Hubitus/Psi_Unit_Firmware/docs/ru/USER_GUIDE.md

> **Языки:** [English](../../USER_GUIDE.md) | Русский

> Руководство пользователя прибора **Psi_Unit** (прошивка **v0.1.0**).  
> Сборка и прошивка — [README.md](README.md), [HARDWARE.md](../../HARDWARE.md), [BOM.md](BOM.md).

# Инструкция по эксплуатации
Документ для **эксплуатации готового прибора**: меню OLED, Wi‑Fi, безопасность, ошибки.  
Не описывает пайку, загрузку прошивки и внутреннюю архитектуру кода.

**Содержание**

- [Назначение прибора](#назначение-прибора)
- [Первое включение](#первое-включение)
- [Маркировка разъёмов на корпусе](#маркировка-разъёмов-на-корпусе)
- [Допустимые нагрузки](#допустимые-нагрузки)
- [Безопасность при подключении и обслуживании](#безопасность-при-подключении-и-обслуживании)
- [Органы управления](#органы-управления)
- [Главный экран — что означают строки](#главный-экран-что-означают-строки)
- [Меню настройки](#меню-настройки)
- [Wi‑Fi и веб-интерфейс](#wi-fi-и-веб-интерфейс)
- [Режимы работы (Mod)](#режимы-работы-mod)
- [Датчики](#датчики)
- [Часы DS3231 и резервная батарейка (VBAT)](#часы-ds3231-и-резервная-батарейка-vbat)
- [Ошибки и индикация](#ошибки-и-индикация)
- [Заводские настройки (после сброса)](#заводские-настройки-после-сброса)
- [Словарь сокращений на дисплее](#словарь-сокращений-на-дисплее)
- [Советы по эксплуатации](#советы-по-эксплуатации)

---

## Назначение прибора

**Psi_Unit** — локальный двухзонный климат-контроллер. Он:

- измеряет температуру и влажность (основная зона — **GRH**);
- измеряет температуру второй зоны (**INC**, датчик DS18B20);
- по заданным правилам управляет нагревом (**GRH** и **INC**), увлажнителем, вентилятором и освещением;
- хранит настройки во внутренней памяти платы (переживают отключение питания);
- использует модуль RTC (расписание света, запись логов и отображение времени).

Управление — **экран OLED**, **энкодер** и опционально **веб через Wi‑Fi** (точка доступа SoftAP).

## Первое включение

Краткий чеклист перед работой с нагрузками:

1. **Подключение** — датчики и силовые линии монтируйте при **отключённом** питании прибора ([безопасность](#безопасность-при-подключении-и-обслуживании)).
2. **Питание** — включите прибор; на главном экране должны появиться время и показания датчиков (или **ERR!** / **RTC ERROR!** — см. [ошибки](#ошибки-и-индикация)).
3. **Время** — **SET → TIME** или, после включения Wi‑Fi, веб **Settings → Clock & date → Sync from this phone** ([подробнее](#wi-fi-и-веб-интерфейс)).
4. **Режимы каналов** — в меню **INC**, **GRH**, **HUM**, **FAN**, **LGT** проверьте **Mod** (после [сброса](#заводские-настройки-после-сброса) все каналы в **OFF**).
5. **Wi‑Fi** (по желанию) — **SET → WiFi → Wi-Fi SoftAP → ON**, затем **QR-code** или адрес **`http://192.168.4.1`** ([подробнее](#wi-fi-и-веб-интерфейс)).

Расшифровка коротких подписей на OLED — в [словаре сокращений](#словарь-сокращений-на-дисплее) в конце документа.

## Маркировка разъёмов на корпусе

На корпусе прибора, над разъёмами, нанесена маркировка (вертикальные черты).

| Штрихи на корпусе | Канал | Нагрузка |
|---|---|---|
| **I** | INC | Нагрев второй зоны (по DS18B20) |
| **II** | GRH | Основной нагрев |
| **III** | HUM | Увлажнитель |
| **IIII** | FAN | Вентилятор |
| **IIIII** | LGT | Освещение (PWM) |

**Разъёмы датчиков** отдельной маркировкой не подписаны: ошибочное подключение исключено **механически** — у каждого типа датчика свой разъём с **разным числом контактов** (разъём не вставляется в «чужой» порт).

**Питание** обозначено **стандартным символом включения питания** (круг с горизонтальной чертой сверху). Подключайте шнур питания только к этому разъёму.

## Допустимые нагрузки

Контроллер только включает/выключает модули; ток в силовой цепи он **не** ограничивает. Ниже — **консервативный** предел для типовых китайских модулей (без гарантий качества).

| Разъём | Канал | Модуль | Нагрузка | Рекомендуемая макс. мощность |
|---|---|---|---|---|
| **I** | INC | SSR G3MB-202P, 230 V AC | Нагрев 2-й зоны | **~230 W** (≤ **1 A**) |
| **II** | GRH | то же | Основной нагрев | **~230 W** (≤ **1 A**) |
| **III** | HUM | то же | Увлажнитель 230 V | **~230 W** (≤ **1 A**) |
| **IIII** | FAN | MOSFET DC | Вентилятор 12 V (по умолчанию) или 5 V | **~60 W** (≤ **5 A**) при 12 V |
| **IIIII** | LGT | то же, PWM | Свет 12 V (по умолчанию) или 5 V | **~36 W** (≤ **3 A**) при 12 V |

**SSR:** питание катушки **5 V**; коммутируемая сторона — только **AC 230 V**, не DC; нагрузка **≥ ~0,1 A**, иначе может не гаснуть; в OFF возможна утечка (~1 mA). **MOSFET:** логика модуля — **3,3 V** с Arduino; питание нагрузки **12 V по умолчанию** или **5 V** при установке перемычки **Solder Bridge** на PCB ([HARDWARE.md](../../HARDWARE.md#power-distribution)). При PWM свет греется сильнее — лимит ниже, чем у FAN.

Для **GRH** и **INC** — одинаковые коврики **Lerway Indoor Greenhouse Heating Mat** 52,7×25,4 cm (~21 W), **по одному на зону** (разъёмы **II** и **I**). Полный перечень — [BOM.md](BOM.md).

Монтаж **230 V** — только при **обесточенном** приборе ([безопасность](#безопасность-при-подключении-и-обслуживании)).

## Безопасность при подключении и обслуживании

| Что подключаете | Питание прибора | Комментарий |
|---|---|---|
| Нагрузка **~230 V** (нагрев **GRH**, увлажнитель **HUM**, зона **INC** через SSR; любая силовая цепь в розетке) | **Обязательно выключено** | Работы только при **полном обесточивании** прибора **и** обесточенной/разомкнутой коммутируемой нагрузке. Подключение или перепайка под напряжением **запрещено** — риск поражения током и короткого замыкания. |
| Низковольтные линии (**FAN**, **LGT** — нагрузка MOSFET, 12 V или 5 V по перемычке на PCB) | **Настоятельно выключено** | Опасность ниже, чем у 230 V, но при включённом приборе реле может сработать в момент монтажа. |
| **Датчики** (FS400-SHT30, DS18B20, разъёмы с разным числом контактов) | **Настоятельно выключено** | Датчики питаются от Arduino **3,3 V** (I2C / OneWire); горячее подключение **не предусмотрено** как нормальный режим. При включённом питании возможны всплески на шине, **ERR!** на экране, сбой опроса; в неаккуратной сборке — повреждение датчика или линии I2C. После правильного подключения при включённом питании прошивка **обычно сама** восстанавливает связь (см. опрос SHT30/DS18B20). **Рекомендация:** отключите питание прибора, подключите датчик, убедитесь в правильном разъёме, затем включите питание. |
| Батарейка **CR2032** на модуле RTC | **Обязательно выключено** | См. [замену батарейки](#замена-и-проверка). |

## Органы управления

| Действие | Результат |
|---|---|
| **Короткое нажатие** кнопки | Подтверждение / вход в пункт меню |
| **Долгое нажатие** (~1 с) | Назад / отмена (зависит от экрана) |
| **Поворот энкодера** | Выбор пункта или изменение значения |

На **главном экране**:

- короткое нажатие → главное меню (**MENU**): порядок пунктов **INC**, **GRH**, **HUM**, **FAN**, **LGT**, **SET**, **BACK**;
- долгое нажатие → быстрый вкл/выкл света (режим **OVR** у строки LGT). Это временная функция, настройки света в памяти не меняются; повторное долгое нажатие снимает OVR; через **2 ч** (по умолчанию) OVR снимается сам.

Если долго не трогать меню (около 5 минут), контроллер сам вернётся на главный экран. Экран может погаснуть через время бездействия — параметр **Sleep** в **SET → DISP**; любое действие энкодером пробуждает дисплей.

## Главный экран — что означают строки

```
  HH:MM:SS   [WiFi]        DD/MM/YY
  ─────────────────────────────────────
  INC: 23.4°C  │  GRH: 24.1°C
               │  HUM: 65%
  ─────────────────────────────────────
  INC   LGT   GRH        ← сетка 3×2
  FAN   ---   HUM        ← инверсия = вкл
```

- Между временем и датой — **иконка Wi‑Fi**, если SoftAP включён.
- **GRH** — температура основной зоны; **HUM** — влажность (%).

- **ERR!** вместо числа — датчик не даёт достоверных данных (см. раздел «Ошибки»).
- **RTC ERROR!** — часы недоступны; расписание света в AUTO не работает, пока не настроите время (**SET → TIME**).
- **NO NVS** внизу — память настроек недоступна; после перезагрузки будут заводские значения, изменения могут не сохраняться.
- Подпись режима: **AUT** (авто), **ON** (принудительно вкл), **OFF** (принудительно выкл), **MAN** (ручной цикл — только увлажнитель).
- **OVR** у LGT — активен быстрый свет с главного экрана.
- Строка устройства **инвертирована** (белый фон) — выход **сейчас включён**.

## Меню настройки

Главное меню → выбор раздела → подменю → изменение параметра → короткое нажатие **сохраняет** значение (запись в память через ~0,5 с).

| Раздел | Что настраивается |
|---|---|
| **INC** | Mod (режим), Tmp (целевая °C), THy (гистерезис **0,1…5,0** °C) — по DS18B20 |
| **GRH** | Mod, Tmp, THy (гистерезис **0,1…5,0** °C) — основной нагрев (SHT30) |
| **HUM** | Mod, Hum (%), HHy (%), Max (мин), Wrk + Unt (вкл), Rst + Unt (пауза) |
| **FAN** | Wrk + Unt (вкл), Rst + Unt (пауза), Mod |
| **LGT** | Mode, Start (час начала), Duration (ч), Brightness (PWM, %, шаг 10 %) |
| **SET** | WiFi, RGB, DISP, TIME, LOG (если в прошивке), SYS, RESET, BACK |

**Диапазоны:** гистерезис температуры (**GRH**, **INC**) — **0,1…5,0 °C**; яркость света (**LGT Brightness**) — шаг **10 %** (OLED и веб).

В **INC**, **GRH** и подменю **WiFi** / **RGB** / **LOG** строки списка разнесены чуть шире (межстрочный интервал ~12 px).

**SET → WiFi:** **Wi-Fi SoftAP** — вкл/выкл точки доступа; **QR-code** — QR-код и текст SSID/пароль/IP; **Timeout** — автоотключение SoftAP (мин; **Never** = без лимита). Подробная процедура — раздел [«Wi‑Fi и веб-интерфейс»](#wi-fi-и-веб-интерфейс).

**SET → LOG:** **Enable** — запись истории датчиков во flash; **Interval** — 5–15 мин; **Save** — применить (в веб: переключатель и кнопки интервала сохраняются по нажатию).

**SET → RESET:** подтверждение «YES Reset default!» — энкодером выбрать YES, короткое нажатие выполнит сброс.

**SET → TIME:** поля год/месяц/день/час/минута; короткое нажатие — выбор поля → правка энкодером → следующее поле; в конце **Save** / **BACK** записывает время в RTC или отменяет. Альтернатива — синхронизация с телефона через веб (см. ниже).

**SET → SYS:** прокручиваемый список диагностики; заголовки разделов — **инверсией**; в конце списка пункт **BACK** (энкодером прокрутить до конца → короткое нажатие). Долгое нажатие — выход в любой момент.

## Wi‑Fi и веб-интерфейс

Контроллер создаёт **собственную Wi‑Fi сеть** в режиме **SoftAP** (*Soft Access Point* — точка доступа). В меню прибора этот режим называется коротко **WiFi**; в веб-настройках — **Wi‑Fi Soft Access Point**. К домашнему роутеру прибор **не подключается** — только вы подключаетесь к его сети с телефона или ноутбука, чтобы открыть страницу настроек в браузере.

### 1. Включение точки доступа (SoftAP)

1. На OLED: **главный экран** → короткое нажатие → **SET** → **WiFi**.
2. Пункт **Wi-Fi SoftAP** → **ON** → короткое нажатие (сохранить).
3. Подождите несколько секунд. Признаки успеха:
   - на главном экране между временем и датой — **иконка Wi‑Fi**;
   - RGB (если включён): зеленое "дыхание" изменяется на синее при исправных датчиках;
   - в Serial Monitor (115200): строки `[WiFi] SSID=…`, `Pass=…`, `URL=http://192.168.4.1`.

По умолчанию Wi‑Fi **не включается** при подаче питания — нужно вручную: **SET → WiFi → Wi-Fi SoftAP → ON**.

Пункт меню **WiFi** показывает **фактическое** состояние SoftAP (ON только если точка доступа реально работает), а не «забытое» значение из памяти.

**WiFi OFF** (или команда в Serial Monitor — см. [README.md](README.md)) выключает SoftAP и запоминает «пользователь выключил» — контроллер **не** поднимает сеть снова каждые 5 с.

Если вы уже включали SoftAP и сохранили предпочтение «вкл», после **перезагрузки** Wi‑Fi сеть прибора может **восстановиться** автоматически (пока не сделаете WiFi OFF или не истечёт **Timeout**).

### 2. Имя сети и пароль

| Способ | Где смотреть |
|---|---|
| **QR на OLED** | SET → WiFi → **QR-code** — первый экран: QR для подключения к Wi‑Fi; поворот энкодера — страницы **S:** (SSID), **P:** (пароль), **U:** / **http://** (адрес) |
| **Serial Monitor** (USB) | Имя сети `SSID=PsiUnit-XXXX`; пароль — на OLED (**QR-code**) или при диагностике через USB (см. [README.md](README.md)) |
| **Веб** | **Settings → Wi‑Fi** — SSID, IP и QR; пароль в браузере **не показывается** |

- **SSID:** `PsiUnit-` + 4 hex-символа (уникально для каждой платы), например `PsiUnit-A3F2`.
- **Пароль:** 8 символов, **сохраняется в памяти платы** — при повторном включении WiFi тот же пароль.
- **Адрес в браузере:** **`http://192.168.4.1`** (не `https`).

### 3. Подключение телефона или компьютера

**Android / iPhone**

1. Настройки → Wi‑Fi → выберите сеть **PsiUnit-XXXX**.
2. Введите пароль (или отсканируйте QR с экрана контроллера).
3. Если система пишет «нет интернета» — это **нормально**: сеть только для доступа к прибору, интернет через неё не идёт. Оставайтесь в этой сети.
4. Откройте браузер (Chrome, Safari…) и введите: **`http://192.168.4.1`**

**Windows / macOS**

1. Подключитесь к **PsiUnit-XXXX** в списке Wi‑Fi, введите пароль.
2. Браузер: **`http://192.168.4.1`**

Если страница не открывается: убедитесь, что WiFi ON, вы в сети PsiUnit (не в домашней Wi‑Fi), адрес с **`http://`**, без пробелов.

**Вход в веб-интерфейс:** по умолчанию **без** отдельного пароля в браузере — достаточно пароля **Wi‑Fi сети** прибора. Дополнительная защита API настраивается при сборке (см. [README.md](README.md)).

### 4. Главная страница (Dashboard)

Открывается по адресу **`http://192.168.4.1/`** — тёмная мобильная вёрстка, интерфейс на **английском**.

| Элемент | Назначение |
|---|---|
| Карточки **INC / GRH °C / GRH %** | Текущие показания; **ERR** — ошибка датчика; **нажатие** — история (график), если включён Log |
| **Time** | Время и дата с RTC |
| Плитки **GRH, HUM, FAN, LGT, INC** | Состояние выхода (подсветка = вкл) и режим (AUT/ON/OFF/MAN); **нажатие** — страница настроек этого канала |
| **Light override (OVR)** | Как долгое нажатие на главном экране OLED — временный свет |
| **Settings** | Общие настройки (часы, дисплей, RGB, Wi‑Fi, журнал) |
| **System Info** | Диагностика (как **SET → SYS** на OLED) |

Данные обновляются автоматически (~2 с). В шапке: версия прошивки и **uptime**. При потере связи сверху появляется красная полоса **No connection to device**.

### 5. Страницы настроек (Settings)

Путь: **Settings** на главной или нажатие на плитку канала на Dashboard.

- Поля совпадают с OLED-меню (режим, уставки, таймеры, яркость света и т.д.).
- Вверху строка **Live:** — текущее состояние выхода (ON/OFF и режим AUT/ON/OFF/MAN).
- **Режимы** (AUTO | ON | OFF | MAN) — ряд кнопок; **сохраняются сразу по нажатию**.
- **Переключатели** (одна кнопка ON/OFF): поворот/инверсия дисплея, RGB LED, Wi‑Fi SoftAP, запись журнала — тоже **по нажатию**.
- **Выбор из нескольких вариантов** (кнопки, не списки): единицы времени (Sec/min), таймаут Wi‑Fi, интервал журнала (5/10/15 m) — **по нажатию**.
- **Числовые поля** (температура, гистерезис, таймеры, сон экрана, яркость **OLED / RGB / LGT**…) — **кнопка с числом** → по нажатию всплывает **колесо** (как на iPhone); затем **Save** (~0,5 с в NVS).
- **Cancel** — отменить несохранённые правки в числовых полях.
- **Home** — вернуться на главную.
Раздел **Settings** (хаб):

| Пункт | Содержание |
|---|---|
| **Clock & date** | Синхронизация часов (см. ниже) |
| **Display** | Slp (число + Save), яркость OLED (колесо %, шаг 5, + Save), поворот/инверсия (переключатели) |
| **RGB status LED** | Вкл/выкл (переключатель), яркость (колесо %, шаг 10, + Save) |
| **Wi‑Fi** | SoftAP (переключатель), таймаут (кнопки), SSID/пароль/QR |
| **Sensor history log** | Вкл (переключатель), интервал 5/10/15 m (кнопки), очистка данных |
| **Factory reset** | Сброс уставок (как **SET → RESET**) |

### 6. Синхронизация часов (Clock & date)

Нужна, если на OLED **RTC ERROR!** или время сбилось — от этого зависит **расписание света** в режиме AUTO и отметки времени в логах датчиков.

**Через Wi-Fi:**

1. Подключитесь к WiFi прибора и откройте **`http://192.168.4.1`**
2. **Settings** → **Clock & date**
3. Сверьте **Phone time** (время телефона) и **Device time (RTC)** (время в чипе DS3231)
4. Нажмите **Sync from this phone** — время телефона запишется в RTC
5. При успехе — зелёное сообщение **Clock synced successfully**; время на главном экране OLED и в карточке **Time** обновится

Используется **локальные часы телефона/компьютера**. Часовой пояс — тот, что выставлен на вашем устройстве.

**Через OLED:** **SET → TIME** (ручной ввод) — см. выше.

По умолчанию контроллер сам переводит часы на **летнее/зимнее время** по правилам ЕС.

### 7. История датчиков (графики)

Если в прошивке включён **Sensor log** и в меню **SET → LOG → Enable ON**:

- На главной странице **нажмите** на карточку INC, GRH °C или GRH %.
- Откроется график; кнопки периода **6 h / 24 h / 7 d / 30 d**.

Запись идёт во flash каждые **5–15 мин** (настраивается); хранится порядка **30 суток** при минимальном интервале.

### 8. Автоотключение Wi‑Fi (Timeout)

**SET → WiFi → Timeout** или веб **Settings → Wi‑Fi → Soft Access Point auto-off timeout**:

| Значение | Поведение |
|---|---|
| **Never** (0) | SoftAP работает, пока не выключите **WiFi OFF** |
| **30 / 60 / 120 / 240 мин** | SoftAP выключится через выбранное время; в меню **WiFi** станет OFF (предпочтение сохраняется) |

**По умолчанию** таймаут **30 мин** — если точка доступа сама отключается, установите **Never** для постоянной работы.

После отключения SoftAP (вручную, по Timeout или через Serial Monitor) веб недоступен до повторного **WiFi ON**.

### 9. Ограничения

- Одновременно до **4** клиентов Wi‑Fi.
- Нет удалённого доступа через интернет — только рядом с прибором, в его сети.
- Веб и OLED меняют **одни и те же** настройки; последнее сохранённое значение действует для обоих.
- MQTT и подключение к домашней Wi‑Fi **не поддерживаются**.

## Режимы работы (Mod)

Общие режимы (где доступны):

| Режим | Поведение |
|---|---|
| **AUTO** | Автоматика по датчику или расписанию (см. ниже) |
| **ON** | Выход включён постоянно (с ограничениями по ошибкам датчиков) |
| **OFF** | Выход выключен |
| **MAN** | **HUM** (и цикл вентилятора): работа — пауза по **Wrk/Rst** |

### GRH — нагрев по SHT30 (основная зона)

- **AUTO:** вкл, если температура **ниже** (цель − гистерезис); выкл, когда **достигла цели**; между порогами сохраняется прежнее состояние (нет «дребезга»).
- **ON:** нагрев вкл, если нет ошибки датчика GRH.
- При ошибке GRH нагрев в AUTO/ON **не включается**, а если был включен - выключается.

### HUM — увлажнение по влажности SHT30

- **AUTO:** как нагрев, но по **влажности** (%); параметр **Max** ограничивает непрерывную работу (минуты), после чего увлажнитель выключается до следующего цикла логики.
- **MAN:** повторяющийся цикл: Wrk (работа) → Rst (пауза); для Wrk и Rst — **свои** единицы (сек/мин), как у вентилятора. **Max** — всегда в минутах. При **ошибке влажности** цикл **не выполняется**, увлажнитель **OFF** (без дребезга SSR).
- **ON:** вкл без AUTO, если нет ошибки влажности.

### FAN — вентилятор

- **AUTO:** циклы работа/пауза по Wrk и Rst (у каждого своё Unt: сек или мин).
- **ON / OFF:** постоянно вкл / выкл.

### LGT — освещение (PWM)

- **AUTO:** вкл в интервале **[Start … Start+Duration)** по часам RTC (24‑часовой формат). Яркость — **Brightness** (0–100%).
- **ON / OFF:** постоянно вкл / выкл на заданной яркости.
- **OVR** с главного экрана — принудительный свет поверх режима в меню; сбрасывается через **2 ч** (по умолчанию) или при ошибке GRH.

### INC — нагрев второй зоны (DS18B20)

- **AUTO / ON / OFF** — по той же логике гистерезиса, что **GRH**, но по линии **INC** и своим Tmp/THy.
- При ошибке DS18B20 нагрев INC в AUTO/ON **не включается**, а если был включен - выключается.

## Датчики

| Обозначение | Датчик | Назначение |
|---|---|---|
| **GRH** | FS400-SHT30 | Основная температура; также **H** — влажность |
| **INC** | DS18B20 | Температура второй зоны |
| Часы | DS3231 (RTC) | Время на экране и расписание света |

- Показания **сглаживаются** (EMA), обновление примерно каждые **2 с**; у SHT30 температура и влажность — **один** I2C-замер (`readBoth`).
- При кратковременном сбое контроллер **сам переподключает** SHT30 и DS18B20 (интервалы 2 → 5 → 10 → 30 с).
- После **3 подряд неудачных** чтений или **10 с** без валидных данных значение считается недостоверным → **ERR!** (у SHT30 T и H обычно пропадают **вместе**).

## Часы DS3231 и резервная батарейка (VBAT)

Модуль **DS3231** держит время и календарь при отключении питания контроллера за счёт отдельной батарейки на плате RTC (цоколь **2032**, 20 мм). Ток резервного питания у DS3231 — порядка **микроампер**, поэтому при исправной схеме и новой элементе питания батарея обычно служит много лет.

### Какую батарейку ставить

Используйте литиевую монету **CR2032** (~3,0 V, **не** перезаряжаемая), цоколь **2032** (20 мм). Берите элемент известного бренда, не просроченный.

Модуль RTC питается от Arduino **3,3 V**. На многих платах DS3231 (в т.ч. ZS‑042) с завода стоит схема **подзарядки** с линии **VCC** (резистор + диод). Если вставить обычную **CR2032**, модуль может **пытаться её заряжать** — батарейка вздувается и выходит из строя за **1–3 года** вместо ожидаемых **7–10 лет**. Рекомендуется **отключить подзарядку**: на типовых платах снимают резистор **102** (1 kΩ) или, на некоторых платах, **201** (200 Ω) рядом с диодом в цепи батареи, чтобы с **VCC** на элемент питания не шёл ток.

Линия **VBAT** у DS3231 рассчитана примерно на **2,3–3,7 V**; CR2032 этому соответствует.

### Когда батарейку пора заменить

Признаки **разряженной или неисправной** элементы питания (при исправной шине I2C и модуле DS3231):

- после отключения питания время **сбрасывается** или «уезжает» на годы назад;
- на экране **RTC ERROR!** (часы недоступны по I2C — см. ниже), хотя раньше работали;
- расписание света **LGT AUTO** срабатывает не в то время;
- батарейка **вздута**, подтекает, была в держателе **много лет** без замены.

**RTC ERROR!** в прошивке означает прежде всего отсутствие или сбой связи с чипом DS3231 (I2C, пайка, модуль). Разряженная батарейка — одна из частых причин потери времени при пропадании сети 220 V, но не единственная. Если ошибка постоянная при включённом питании — проверьте I2C и модуль RTC, а не только батарейку.

### Замена и проверка

1. Отключите питание контроллера.
2. Отвинтите 4 винта М2 крепления крышки прибора, аккуратно приподнимите крышку и отсоедините шлейф экрана от электронной платы. Часы RTC находятся на крышке прибора, рядом с модулем экрана.
3. Установите новую батарею **CR2032**.
4. Включите питание → **SET → TIME** или **веб → Clock & date → Sync from this phone** — задайте правильные дату и время.
5. Контроль: отключите питание на **5–10 минут**, включите снова — время и дата должны сохраниться.

## Ошибки и индикация

| Признак | Значение |
|---|---|
| **ERR!** на главном экране | Нет данных с этого датчика |
| **RTC ERROR!** | Нет связи с DS3231 по I2C — проверьте модуль и шину; после восстановления задайте время в **SET → TIME**. Сбой времени при отключении питания — см. [батарейку RTC](#часы-ds3231-и-резервная-батарейка-vbat) |
| **NO NVS** | Настройки не сохраняются в flash; **все выходы принудительно OFF** (см. critical fault ниже) |
| RGB **зелёное «дыхание»** | Датчики в норме, Wi‑Fi выкл (**SET → RGB → Enable ON**) |
| RGB **синее «дыхание»** | SoftAP активен, датчики в норме |
| RGB **оранжевый/красный** | Ошибка датчика (приоритет выше синего Wi‑Fi) |
| RGB выкл | LED OFF в меню RGB |

### Быстрая диагностика

| Симптом | Что проверить | Действие |
|---|---|---|
| **ERR!** у GRH или INC | Проводка, питание датчика | Переподключить при **обесточенном** приборе; обычно восстанавливается само |
| **RTC ERROR!** | Модуль DS3231, батарейка CR2032 | **SET → TIME** или веб Sync; см. [батарейку RTC](#часы-ds3231-и-резервная-батарейка-vbat) |
| **NO NVS** | Память настроек | Все выходы OFF; перезагрузка; при повторении — сервис |
| Wi‑Fi сам отключился | **Timeout** | **SET → WiFi → Never** или снова **WiFi ON** |
| Все выходы OFF, датчики в норме | Critical fault | Проверить **NO NVS** и **ERR!** на всех трёх каналах (GRH °C, GRH %, INC) |

**Безопасность при старте:** первые **3 с** после включения питания все SSR и реле **принудительно выключены**, затем работают выбранные режимы.

**Critical fault (катастрофа):** если **NO NVS** (память настроек недоступна) **или** одновременно **ERR!** на всех трёх каналах (GRH °C, GRH %, INC) — **все выходы OFF**: нагрев, увлажнитель, INC, вентилятор, свет и быстрый свет (**OVR**). Автоматика каналов не выполняется, пока условие не снимется (NVS снова OK или восстановится хотя бы один датчик).

**Защита в AUTO/ON (один ERR!):** нагрев (GRH), увлажнение (HUM) и INC **не включаются** при ошибке «своего» датчика, а если были включены — выключаются. Вентилятор и свет по расписанию/режиму **могут работать**, если нет critical fault.

**Failsafe (каждый цикл):** если SSR/реле уже включены при ошибке «своего» датчика — пины **принудительно гасятся**. **HUM MAN** при ошибке влажности: увлажнитель OFF, цикл work/rest **не крутится** (без дребезга SSR). **Light OVR** сбрасывается при ошибке GRH.

**Дополнительная защита (по умолчанию):** SSR нагрева (**GRH**, **INC**) автоматически гасятся после **4 ч** непрерывной работы; при температуре выше **35 °C** — аварийное отключение нагрева; быстрый свет (**OVR**) сбрасывается через **2 ч**. Пороги настраиваются при сборке (см. [README.md](README.md)).

## Заводские настройки (после сброса)

**SET → RESET** восстанавливает уставки каналов и дисплея к заводским значениям прошивки. **Wi‑Fi** и **журнал датчиков** хранятся отдельно и **не** сбрасываются RESET.

| Параметр | Значение после RESET |
|---|---|
| **Mod** всех каналов (**INC**, **GRH**, **HUM**, **FAN**, **LGT**) | **OFF** |
| Цель нагрева **GRH** / **INC** (**Tmp**) | **25,0 °C** |
| Гистерезис **THy** (**GRH**, **INC**) | **1,0 °C** |
| Цель влажности **HUM** (**Hum**) | **60 %** |
| Гистерезис влажности **HHy** | **5 %** |
| **HUM Max** (макс. непрерывная работа) | **10 мин** |
| **HUM** цикл MAN: **Wrk** / **Rst** | **5 мин** / **25 мин** |
| **FAN** цикл: **Wrk** / **Rst** | **15 сек** / **10 мин** |
| Свет **LGT**: **Start** / **Duration** / **Brightness** | **08:00** / **12 ч** / **100 %** |
| Сон экрана **Sleep** | **2 мин** |
| Яркость OLED | **50 %** |
| Поворот / инверсия дисплея | **выкл** |
| RGB | **вкл**, яркость **100 %** |

## Словарь сокращений на дисплее

На OLED мало места — в части разделов подписи укорочены, в **SET**, **LGT**, **DISP**, **RGB**, **LOG** и **WiFi** — полные слова. Ниже перечислены подписи, как они отображаются на экране. Если сомневаетесь, сверяйтесь с этой таблицей.

### Каналы, зоны и главное меню

| На экране | Значение |
|---|---|
| **MENU** | Заголовок **главного меню** |
| **INC** | Нагрев второй зоны (DS18B20); пункт меню и строка на главном экране |
| **GRH** | Нагрев **основной** зоны (SHT30) — пункт меню, подпись **температуры** и плитка нагрева на главном экране |
| **HUM** | Увлажнитель (меню и главный экран) |
| **FAN** | Вентилятор |
| **LGT** | Освещение (яркость PWM) |
| **SET** | Системные настройки: Wi‑Fi, дисплей, часы, сброс и т.д. |
| **BACK** | Назад (главное меню → главный экран; подменю → уровень выше) |

### Режимы (Mod) и статусы

| На экране | Значение |
|---|---|
| **AUTO** | Автоматика по датчикам и уставкам (в списке режимов в меню) |
| **AUT** | То же **AUTO** — укорочено на главном экране у канала |
| **ON** | Принудительно **включено** |
| **OFF** | Принудительно **выключено** |
| **MAN** | Ручной **цикл** вкл/пауза (только увлажнитель **HUM**) |
| **OVR** | Временный **принудительный свет** с главного экрана (долгое нажатие), не меняет расписание **LGT** в меню |

### Частые параметры в подменю

| На экране | Значение |
|---|---|
| **Mod** | Режим канала (AUTO / ON / OFF / MAN) |
| **Tmp** | Целевая **температура** (°C) |
| **THy** | **Гистерезис** температуры (°C) — разброс вкл/выкл |
| **Hum** | Целевая **влажность** (%) |
| **HHy** | **Гистерезис** влажности (%) |
| **Max** | Макс. **непрерывная** работа увлажнителя (мин), затем пауза |
| **Wrk** | Время **работы** в цикле MAN (сек или мин) |
| **Rst** | Время **паузы** в цикле MAN (**не** сброс настроек!) |
| **Unt** | **Единица** времени для Wrk/Rst: **sec** / **min** в списке; при правке — **SEC** / **MIN** |
| **Mode** | Режим (полное слово в **LGT**) |
| **Start** | Час **начала** света (0–23), в меню **LGT** |
| **Duration** | **Длительность** света (часы), в меню **LGT** |
| **Brightness** | **Яркость** (OLED, RGB, свет **LGT**) |

### SET — системные пункты

Порядок в меню **SET** (сетка 3×3, слева направо, сверху вниз): **WiFi**, **RGB**, **DISP**, **TIME**, **LOG** (если включён в прошивке), **SYS**, **RESET**, **BACK**.

| На экране | Значение |
|---|---|
| **TIME** | Установка **даты и времени** (RTC); экран правки — **SET CLOCK** |
| **DISP** | Подменю **дисплея** |
| **Sleep** | **Сон** экрана: минуты бездействия до гашения (**0** = не гасить), в **DISP** |
| **Rotate** | **Поворот** изображения на 180°, в **DISP** |
| **Invert** | **Инверсия** цветов дисплея, в **DISP** |
| **RGB** | Подменю **RGB**-индикатора на плате |
| **Enable** | Вкл/выкл (RGB, LOG) |
| **WiFi** | Подменю **Wi‑Fi** (точка доступа SoftAP) |
| **Wi-Fi SoftAP** | Вкл/выкл **собственной Wi‑Fi сети** прибора |
| **QR-code** | QR и текст **SSID / пароль / адрес** |
| **Timeout** | Автоотключение Wi‑Fi через N мин; **Never** — без лимита |
| **LOG** | Подменю **журнала** датчиков |
| **Interval** | **Интервал** записи лога (5–15 мин) |
| **Save** | Сохранить (LOG, часы — **SET CLOCK**) |
| **SYS** | **Системная** информация |
| **RESET** | **Сброс** уставок к заводским (**не** путать с **Rst** у HUM/FAN!) |
| **BACK** | Назад |

На страницах **QR-code** (поворот энкодера): **S:** — имя сети (SSID), **P:** — пароль, **U:** / **http://** — адрес в браузере.

### Сообщения и служебное (SET → SYS)

| На экране | Значение |
|---|---|
| **ERR!** | Нет достоверных данных с **датчика** |
| **RTC ERROR!** | Нет связи с часами **DS3231** |
| **NO NVS** | Не работает память **настроек** на плате |
| **Ver** / **Bld** | Версия прошивки / дата сборки |
| **Up** | Время работы с включения (кратко: `45s`, `12m 30s`, `2d 5h`…) |
| **Heap** / **Min** | Свободная / минимальная **память** контроллера |
| **I2C** | Состояние шины датчиков и RTC |
| **Rst** (в **Sys**) | **Причина** последней перезагрузки чипа (не сброс настроек) |

## Советы по эксплуатации

### Подключение с телефона

Полная процедура включения SoftAP, QR-кода и адреса **`http://192.168.4.1`** — в разделе [«Wi‑Fi и веб-интерфейс»](#wi-fi-и-веб-интерфейс).  
**Совет:** после первого входа создайте ярлык страницы на главном экране телефона (Android: меню браузера → «Добавить на главный экран»; iPhone: «Поделиться» → «На экран "Домой"»).

### Общие рекомендации

1. Перед первым использованием проверьте время (**SET → TIME** или **веб → Clock & date → Sync from this phone**) и режимы всех каналов. Силовую проводку **230 V** и датчики монтируйте при **отключённом** питании прибора (см. [безопасность при подключении](#безопасность-при-подключении-и-обслуживании)).
2. При **ERR!** проверьте проводку и питание датчика; после восстановления показания и RGB вернутся сами.
3. Диагностика: **SET → SYS** или веб **System Info**; при подключённом USB — команды Serial Monitor (см. [README.md](README.md)).
4. Настройка с телефона (рядом с прибором): включите SoftAP и подключитесь по QR (см. [Wi‑Fi](#wi-fi-и-веб-интерфейс)) или вручную к `PsiUnit-XXXX` → **`http://192.168.4.1`**.

Для сборщика после прошивки — [TEST_CHECKLIST.md](TEST_CHECKLIST.md).
