Hubitus/Psi_Unit_Firmware/images/Psi_Unit_Device_Preview_Test.jpg

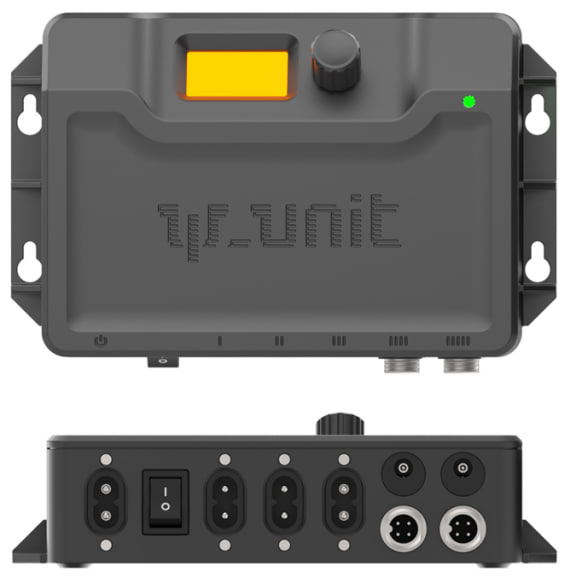
images/Psi_Unit_Device_Preview_Test.jpg
