Hubitus/Psi_Unit_Firmware/docs/Psi_Unit_Wiring_Diagram.pdf

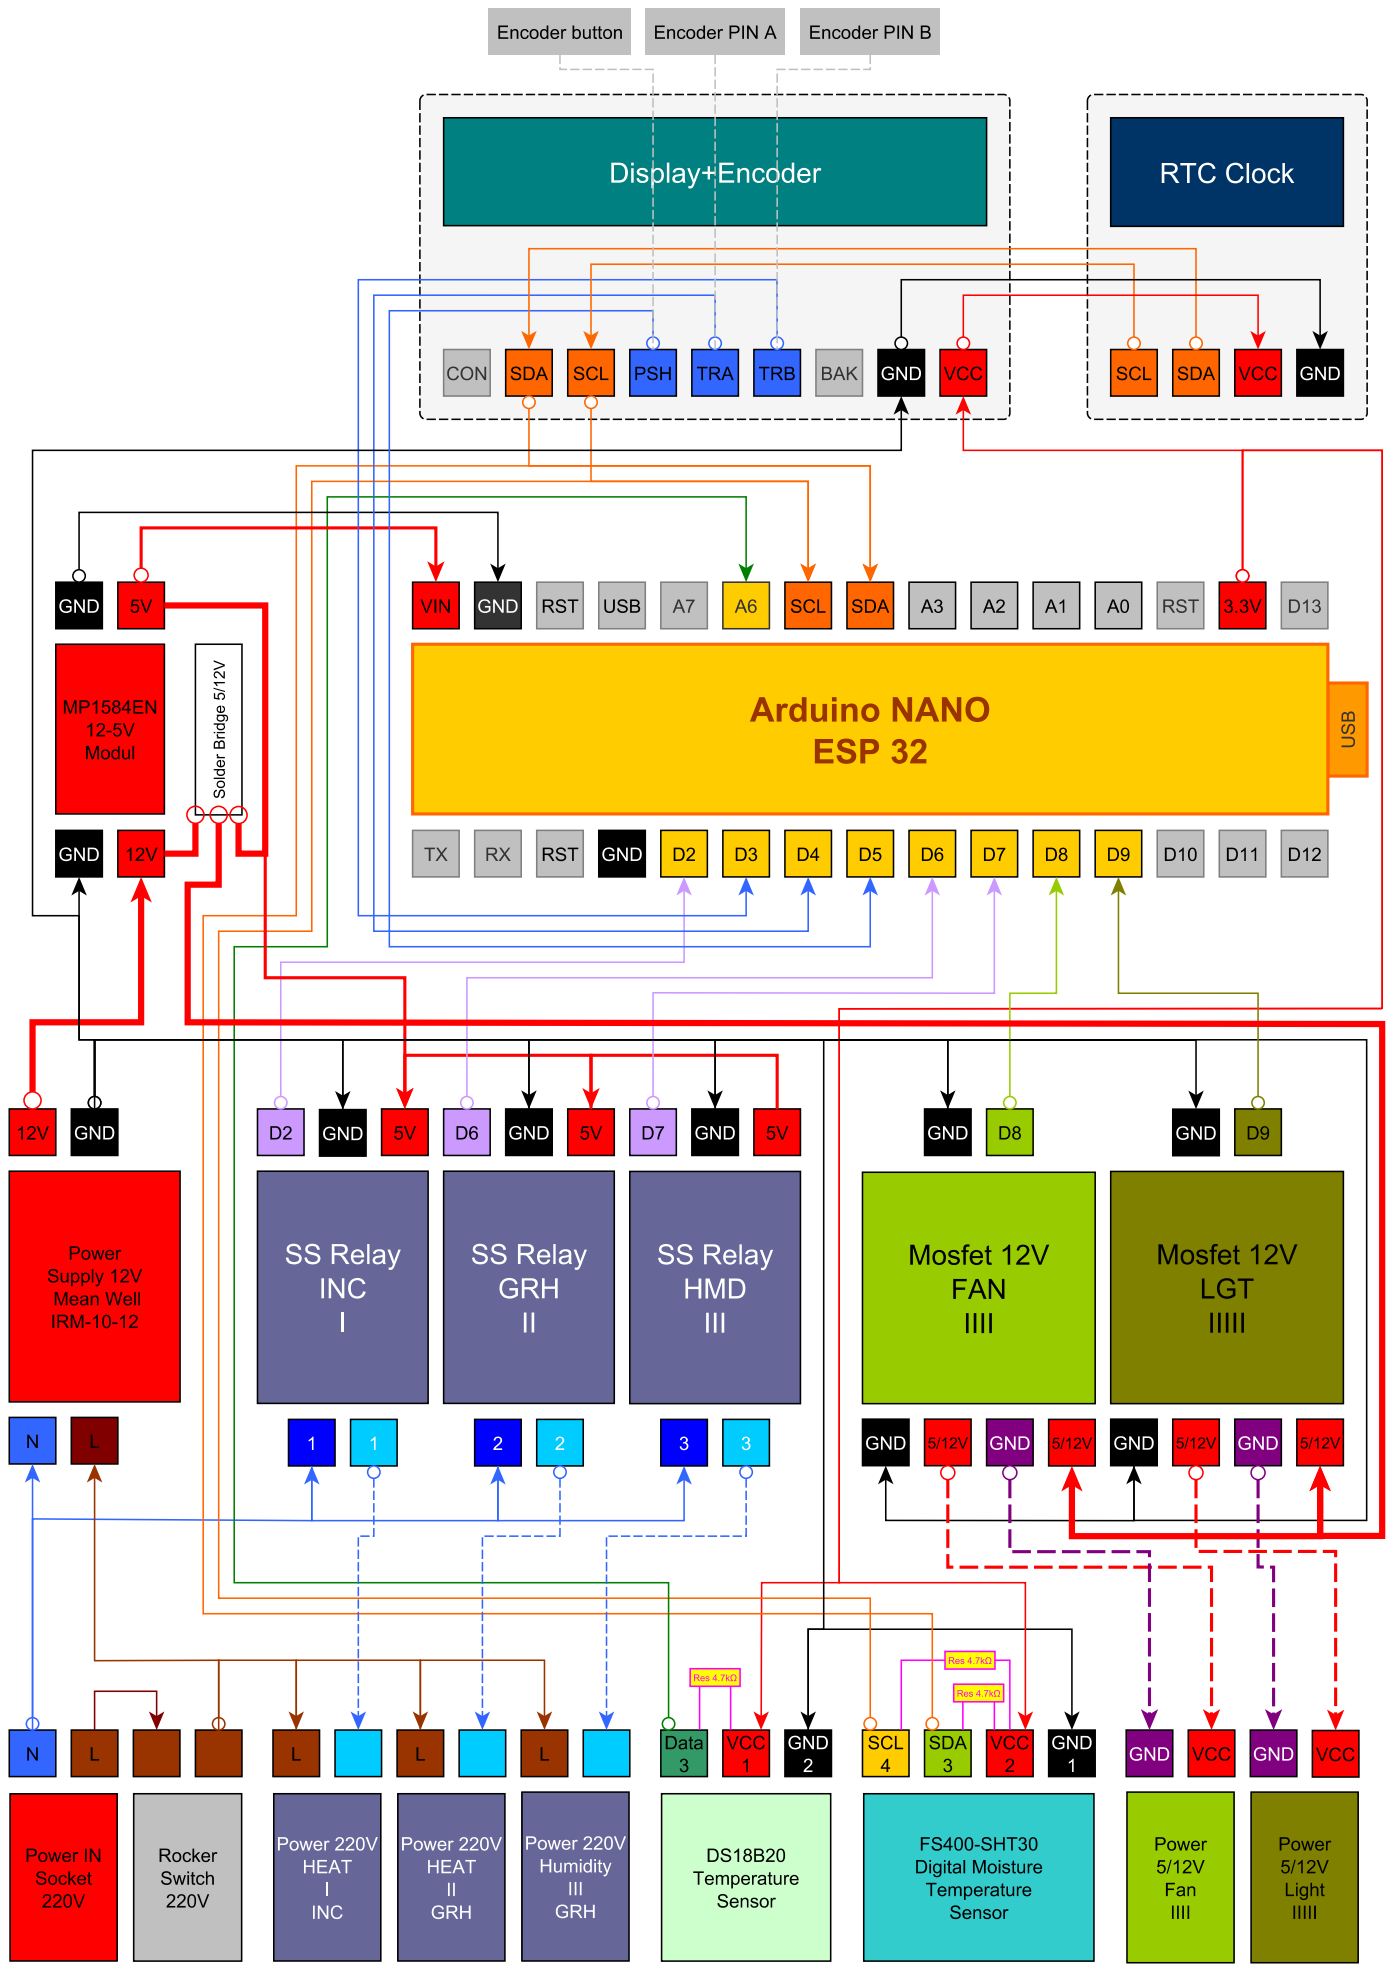
[picture p26: page 1]
