Hubitus/Psi_Unit_Firmware/firmware/Psi_Unit_Firmware/web_logo.h

/*
 * web_logo.h — SVG logo for web UI (PROGMEM)
 *
 * Source: assets/logo.svg
 */
#ifndef WEB_LOGO_H
#define WEB_LOGO_H

#include <Arduino.h>

static const char WEB_LOGO_SVG[] PROGMEM = R"svg(<?xml version="1.0" encoding="utf-8"?>
<!-- Generator: Adobe Illustrator 27.2.0, SVG Export Plug-In . SVG Version: 6.00 Build 0)  -->
<svg version="1.1" id="Layer_1" xmlns="http://www.w3.org/2000/svg" xmlns:xlink="http://www.w3.org/1999/xlink" x="0px" y="0px"
	 viewBox="0 0 99.21 31.18" style="enable-background:new 0 0 99.21 31.18;" xml:space="preserve">
<style type="text/css">
	.st0{fill:#E7ECF3;}
</style>
<g>
	<polygon class="st0" points="68.61,11.09 69.61,11.09 69.61,12.09 69.61,13.09 69.61,14.09 69.61,15.09 69.61,16.09 69.61,17.09 
		69.61,18.09 69.61,19.09 69.61,20.09 69.61,21.09 69.61,22.09 69.61,23.09 70.61,23.09 73.61,23.09 73.61,22.09 70.61,22.09 
		70.61,21.09 73.61,21.09 73.61,20.09 70.61,20.09 70.61,19.09 73.61,19.09 73.61,18.09 70.61,18.09 70.61,17.09 73.61,17.09 
		73.61,16.09 70.61,16.09 70.61,15.09 73.61,15.09 73.61,14.09 70.61,14.09 70.61,13.09 73.61,13.09 73.61,12.09 70.61,12.09 
		70.61,11.09 73.61,11.09 73.61,10.09 68.61,10.09 	"/>
	<polygon class="st0" points="87.61,22.09 87.61,21.09 96.61,21.09 96.61,20.09 87.61,20.09 86.61,20.09 86.61,19.09 89.61,19.09 
		89.61,18.09 86.61,18.09 86.61,17.09 89.61,17.09 89.61,16.09 86.61,16.09 86.61,15.09 89.61,15.09 89.61,14.09 86.61,14.09 
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
	<polygon class="st0" points="77.61,2.09 77.61,3.09 77.61,4.09 77.61,5.09 78.61,5.09 81.61,5.09 81.61,4.09 78.61,4.09 
		78.61,3.09 81.61,3.09 81.61,2.09 78.61,2.09 	"/>
</g>
</svg>
)svg";

#endif // WEB_LOGO_H
