Hubitus/Psi_Unit_Firmware/firmware/Psi_Unit_Firmware/splash.h

/*
 * splash.h — splash screen XBM logo (PROGMEM)
 */

#ifndef SPLASH_H
#define SPLASH_H

#include <Arduino.h>

const uint8_t SPLASH_LOGO_WIDTH = 97;
const uint8_t SPLASH_LOGO_HEIGHT = 31;
const unsigned char splashLogoBits[] PROGMEM = {
    0xff, 0xff, 0xff, 0xff, 0xff, 0xff, 0xff, 0xff, 0xff, 0xff, 0xff, 0xff, 0x01, 0xff, 0xff, 0xff, 
    0xff, 0xff, 0xff, 0xff, 0xff, 0xff, 0xff, 0xff, 0xff, 0x01, 0xff, 0xff, 0xff, 0xff, 0xff, 0xff, 
    0xff, 0xff, 0xff, 0x3f, 0x3c, 0xfc, 0x01, 0xff, 0xff, 0xff, 0xff, 0xff, 0xff, 0xff, 0xff, 0xff, 
    0xbf, 0xbf, 0xff, 0x01, 0xff, 0xff, 0xff, 0xff, 0xff, 0xff, 0xff, 0xff, 0xff, 0x3f, 0x3c, 0xfc, 
    0x01, 0xff, 0xff, 0xff, 0xff, 0xff, 0xff, 0xff, 0xff, 0xff, 0xff, 0xbf, 0xff, 0x01, 0x03, 0xfc, 
    0xff, 0x00, 0x3f, 0xe0, 0x0f, 0x1f, 0x00, 0xfe, 0x3f, 0x00, 0x01, 0xf7, 0xff, 0xff, 0xfe, 0x7f, 
    0xff, 0xef, 0xdf, 0xff, 0xff, 0xbf, 0xff, 0x01, 0x07, 0x7c, 0xf8, 0x80, 0x7f, 0xc0, 0x0f, 0x0f, 
    0x00, 0x3c, 0x3c, 0x80, 0x01, 0xbf, 0x7f, 0xff, 0xfe, 0xff, 0xfb, 0xef, 0xef, 0xff, 0xbf, 0xbf, 
    0xff, 0x01, 0x3f, 0x7c, 0xf8, 0xf0, 0xff, 0xc3, 0x0f, 0x0f, 0x1f, 0x3c, 0x3c, 0xfc, 0x01, 0xbf, 
    0x7f, 0xff, 0xfe, 0xff, 0xfb, 0xef, 0xef, 0xbf, 0xbf, 0xbf, 0xff, 0x01, 0x3f, 0x7c, 0xf8, 0xf0, 
    0xff, 0xc3, 0x0f, 0x0f, 0x3f, 0x3c, 0x3c, 0xfc, 0x01, 0xbf, 0x7f, 0xff, 0xfe, 0xff, 0xfb, 0xef, 
    0xef, 0xbf, 0xbf, 0xbf, 0xff, 0x01, 0x3f, 0x7c, 0xf8, 0xf0, 0xff, 0xc3, 0x0f, 0x0f, 0x3f, 0x3c, 
    0x3c, 0xfc, 0x01, 0xbf, 0x7f, 0xff, 0xfe, 0xff, 0xfb, 0xef, 0xef, 0xbf, 0xbf, 0xbf, 0xff, 0x01, 
    0x3f, 0x7c, 0xf8, 0xf0, 0xff, 0xc3, 0x0f, 0x0f, 0x3f, 0x3c, 0x3c, 0xfc, 0x01, 0xbf, 0x7f, 0xff, 
    0xfe, 0xff, 0xfb, 0xef, 0xef, 0xbf, 0xbf, 0xbf, 0xff, 0x01, 0x3f, 0x7c, 0x78, 0xf0, 0xff, 0xc3, 
    0x07, 0x0f, 0x3f, 0x3c, 0x3c, 0xfc, 0x01, 0xbf, 0x7f, 0xff, 0xff, 0xff, 0xfb, 0xff, 0xef, 0xbf, 
    0xbf, 0xbf, 0xff, 0x01, 0x3f, 0x60, 0x18, 0xf0, 0x80, 0x03, 0x00, 0x0f, 0x3f, 0x3c, 0x3c, 0x00, 
    0x00, 0x7f, 0x7f, 0xdf, 0xff, 0xfe, 0xf7, 0xff, 0xef, 0xbf, 0xbf, 0x7f, 0xff, 0x01, 0x7f, 0x60, 
    0x18, 0x78, 0xc0, 0x07, 0x80, 0x0f, 0x3f, 0x3c, 0x7c, 0x00, 0x00, 0xff, 0x7f, 0xff, 0xff, 0xff, 
    0xff, 0xff, 0xff, 0xff, 0xff, 0xff, 0xff, 0x01, 0xff, 0x7f, 0xf8, 0xff, 0xff, 0xff, 0xff, 0xff, 
    0xff, 0xff, 0xff, 0xff, 0x01, 0xff, 0x7f, 0xff, 0xff, 0xff, 0xff, 0xff, 0xff, 0xff, 0xff, 0xff, 
    0xff, 0x01, 0xff, 0x7f, 0xf8, 0xff, 0xff, 0xff, 0xff, 0xff, 0xff, 0xff, 0xff, 0xff, 0x01, 0xff, 
    0x7f, 0xff, 0xff, 0xff, 0xff, 0xff, 0xff, 0xff, 0xff, 0xff, 0xff, 0x01, 0xff, 0x7f, 0xf8, 0xff, 
    0xff, 0xff, 0xff, 0xff, 0xff, 0xff, 0xff, 0xff, 0x01, 0xff, 0xff, 0xff, 0xff, 0xff, 0xff, 0xff, 
    0xff, 0xff, 0xff, 0xff, 0xff, 0x01, 0xff, 0xff, 0xff, 0xff, 0xff, 0xff, 0xff, 0xff, 0xff, 0xff, 
    0xff, 0xff, 0x01
};

#endif // SPLASH_H
