Hubitus/Psi_Unit_Firmware/sim/include/display_backend_sim.h

#ifndef DISPLAY_BACKEND_SIM_H
#define DISPLAY_BACKEND_SIM_H

#include <stdint.h>

#ifdef __cplusplus
extern "C" {
#endif

void disp_sim_write_pixel(uint8_t x, uint8_t y, uint8_t color);

#ifdef __cplusplus
}
#endif

#endif
