Hubitus/Psi_Unit_Firmware/(notices)

Notices in the files:
docs/ru/README.md:
License: MIT
